hexbus/2708-16-32-to-2764-adapter/hardware/2708-16-32-to-2764-adapter.kicad_pcb

## KiCad design hardware/2708-16-32-to-2764-adapter.kicad_pcb (2026-11-11)

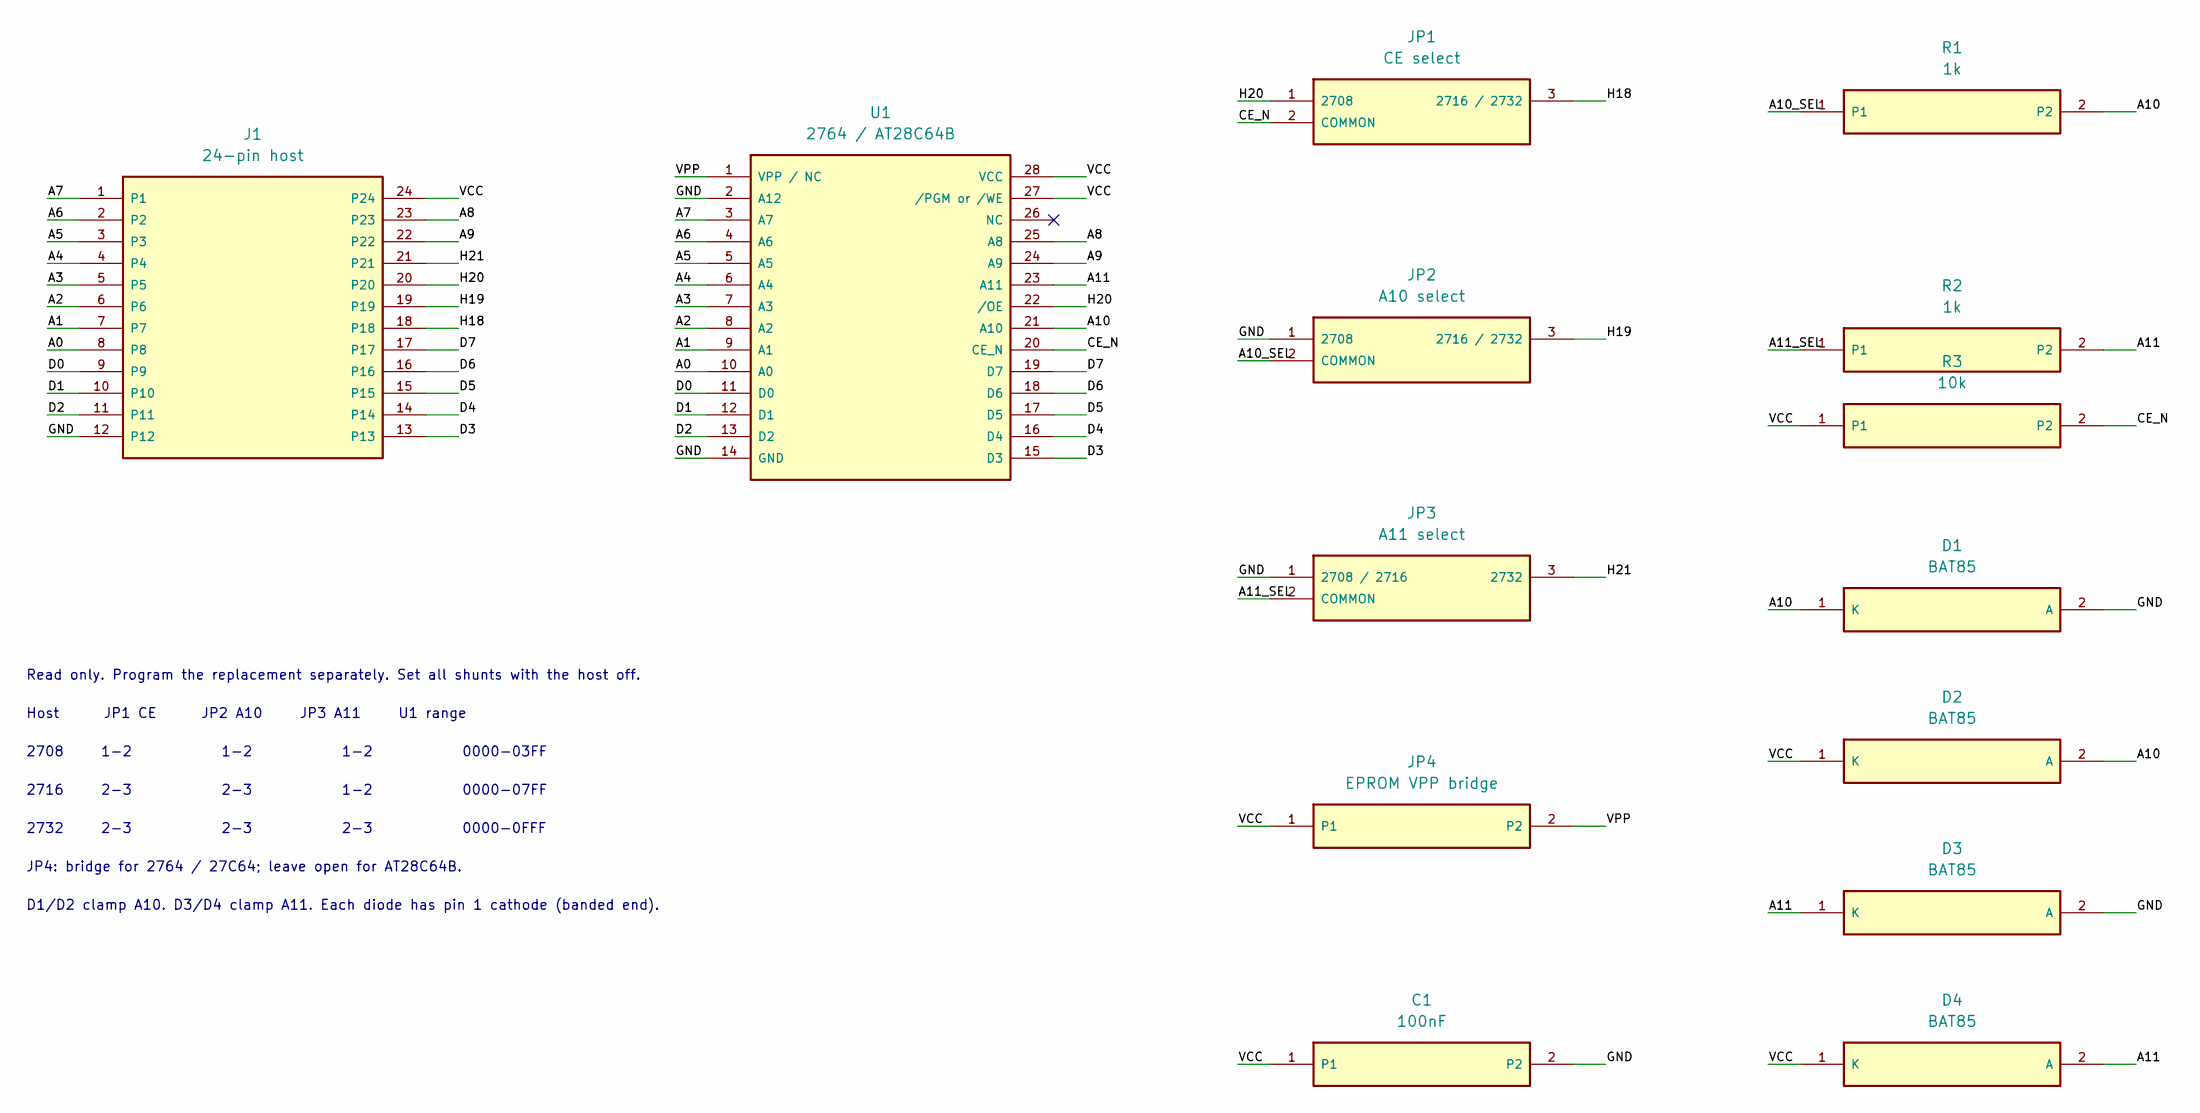
[picture p3: schematic 2708-16-32-to-2764-adapter.kicad_sch]

Parts:
C1: 100nF; C_0805
D1, D2, D3, D4: BAT85; BAT85_Upright
J1: 24-pin host; DIP24_Male_15.24mm
JP1: CE select; Shunt_1x03
JP2: A10 select; Shunt_1x03
JP3: A11 select; Shunt_1x03
JP4: EPROM VPP bridge; SolderJumper_Open
R1, R2: 1k; R_Axial_DIN0204_L3.6mm_D1.6mm_P2.54mm_Vertical
R3: 10k; R_Axial_DIN0204_L3.6mm_D1.6mm_P2.54mm_Vertical
U1: 2764 / AT28C64B; DIP28_SocketStrips_15.24mm

Connections:
/A0: J1.8, U1.10 (A0)
/A1: J1.7, U1.9 (A1)
/A2: J1.6, U1.8 (A2)
/A3: J1.5, U1.7 (A3)
/A4: J1.4, U1.6 (A4)
/A5: J1.3, U1.5 (A5)
/A6: J1.2, U1.4 (A6)
/A7: J1.1, U1.3 (A7)
/A8: J1.23, U1.25 (A8)
/A9: J1.22, U1.24 (A9)
/A10: D1.1 (K), D2.2 (A), R1.2, U1.21 (A10)
/A10_SEL: JP2.2 (COMMON), R1.1
/A11: D3.1 (K), D4.2 (A), R2.2, U1.23 (A11)
/A11_SEL: JP3.2 (COMMON), R2.1
/CE_N: JP1.2 (COMMON), R3.2, U1.20 (CE_N)
/D0: J1.9, U1.11 (D0)
/D1: J1.10, U1.12 (D1)
/D2: J1.11, U1.13 (D2)
/D3: J1.13, U1.15 (D3)
/D4: J1.14, U1.16 (D4)
/D5: J1.15, U1.17 (D5)
/D6: J1.16, U1.18 (D6)
/D7: J1.17, U1.19 (D7)
/GND: C1.2, D1.2 (A), D3.2 (A), J1.12, JP2.1 (2708), JP3.1 (2708 / 2716), U1.2 (A12), U1.14 (GND)
/H18: J1.18, JP1.3 (2716 / 2732)
/H19: J1.19, JP2.3 (2716 / 2732)
/H20: J1.20, JP1.1 (2708), U1.22 (/OE)
/H21: J1.21, JP3.3 (2732)
/VCC: C1.1, D2.1 (K), D4.1 (K), J1.24, JP4.1, R3.1, U1.27 (/PGM or /WE), U1.28 (VCC)
/VPP: JP4.2, U1.1 (VPP / NC)

Notes on the sheet:
Read only. Program the replacement separately. Set all shunts with the host off.
Host JP1 CE JP2 A10 JP3 A11 U1 range
2708 1-2 1-2 1-2 0000-03FF
2716 2-3 2-3 1-2 0000-07FF
2732 2-3 2-3 2-3 0000-0FFF
JP4: bridge for 2764 / 27C64; leave open for AT28C64B.
D1/D2 clamp A10. D3/D4 clamp A11. Each diode has pin 1 cathode (banded end).

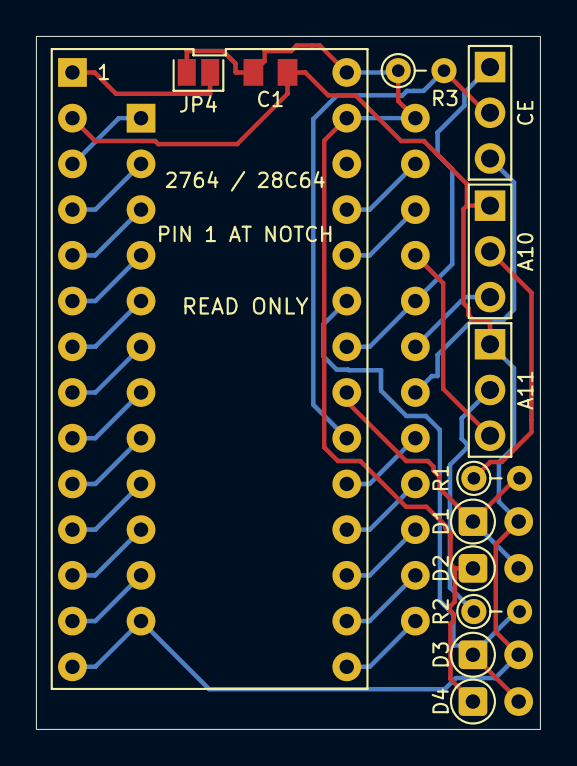
[picture p4: board 2708-16-32-to-2764-adapter.kicad_pcb from above]

Board: 2 copper layers, 28.0 x 38.5 mm, 14 parts (1 on the bottom side), 30 nets.
