hexbus/2708-16-32-to-2764-adapter/(commit log)

2026-11-11 Build compact switchable 2708, 2716 and 2732 ROM adapter
    [2708-16-32-to-2764-adapter.kicad_pcb, 2708-16-32-to-2764-adapter.kicad_sch, bom.csv]
2026-11-11 Clarify shunt settings and outline each selector
    [2708-16-32-to-2764-adapter.kicad_pcb]
2026-11-11 Fit four upright BAT85 clamps in Rev B adapter
    [2708-16-32-to-2764-adapter.kicad_pcb, 2708-16-32-to-2764-adapter.kicad_sch, bom.csv]
2026-11-11 Keep prototype ordering instructions concise
