hexbus/2708-16-32-to-2764-adapter/(notices)

Notices in the files:
hardware/2708-16-32-to-2764-adapter.kicad_pcb:
(c) 2026 REV B
